CRCibernetica/cnft-tpl-esp32cam/README.md

# cnft-tpl-esp32cam
ESP32 camara shield with TPL5110 to control power consumption
