CRCibernetica/cnft-tpl-esp32cam/tpl-esp32/3dparts/TC-33X-1_ASMTC33.step

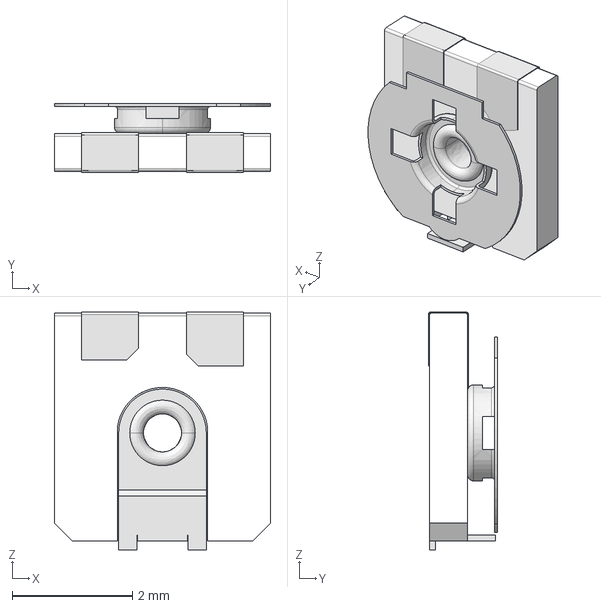
[picture p3: CAD file, 2024-03-14]
tpl-esp32/3dparts/TC-33X-1_ASMTC33.step
3.60 x 1.15 x 3.96 mm
