CRCibernetica/cnft-tpl-esp32cam/tpl-esp32/3dparts/B2B-PH-SM4-TB.step

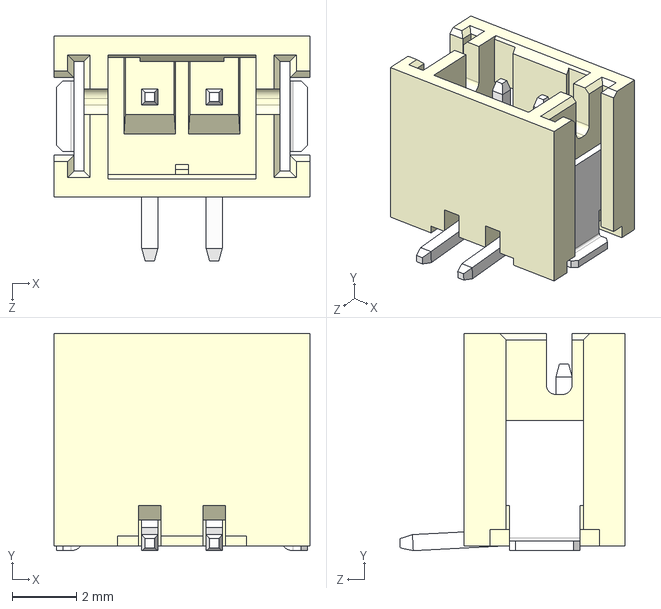
[picture p4: CAD file, 2024-03-14]
tpl-esp32/3dparts/B2B-PH-SM4-TB.step
7.95 x 6.75 x 7.00 mm
