CRCibernetica/cnft-tpl-esp32cam/tpl-esp32/3dparts/jst-sh-smd-connectors-1.snapshot.4/SMxxB-SRSS-TB/SM11B-SRSS-TB.STEP

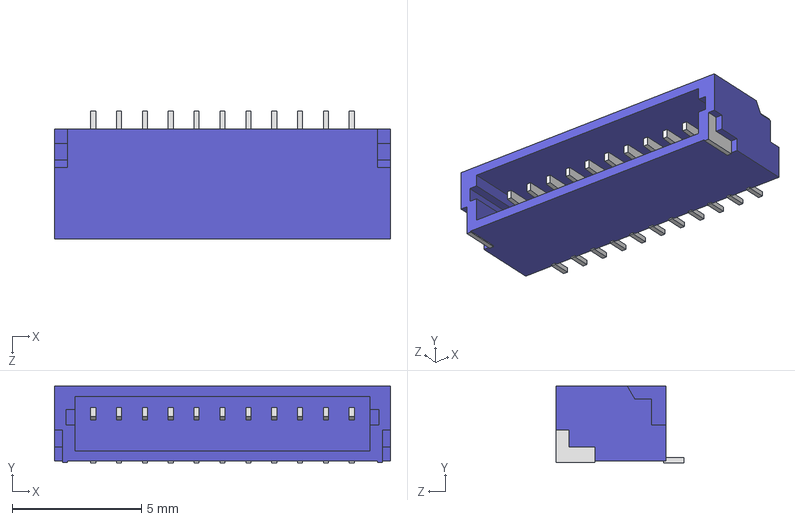
[picture p8: CAD file, 2024-03-14]
tpl-esp32/3dparts/jst-sh-smd-connectors-1.snapshot.4/SMxxB-SRSS-TB/SM11B-SRSS-TB.STEP
13.0 x 2.96 x 4.95 mm
