CRCibernetica/cnft-tpl-esp32cam/tpl-esp32/3dparts/jst-sh-smd-connectors-1.snapshot.4/SSH-003T-P0.2-H/SSH-003T-P0.2-H.STEP

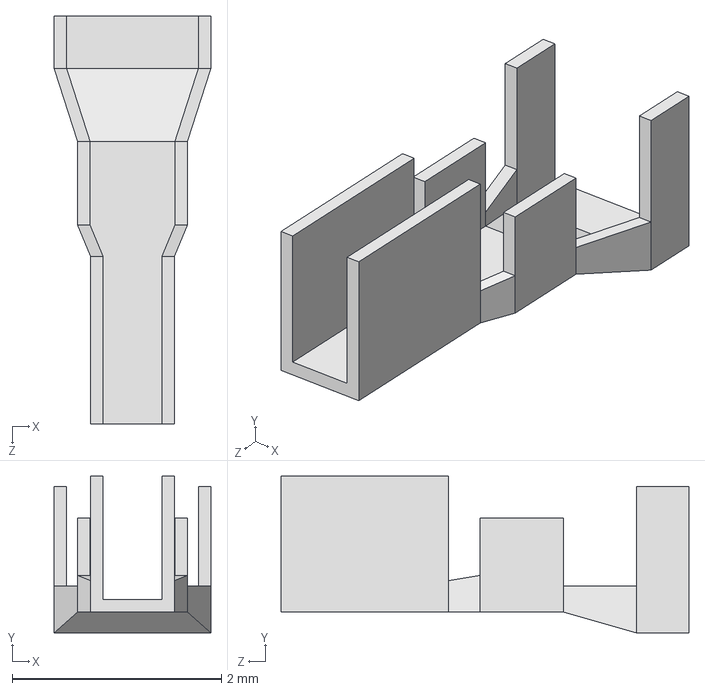
[picture p9: CAD file, 2024-03-14]
tpl-esp32/3dparts/jst-sh-smd-connectors-1.snapshot.4/SSH-003T-P0.2-H/SSH-003T-P0.2-H.STEP
1.50 x 1.50 x 3.90 mm
