CRCibernetica/cnft-tpl-esp32cam/tpl-esp32/3dparts/SOT23.step

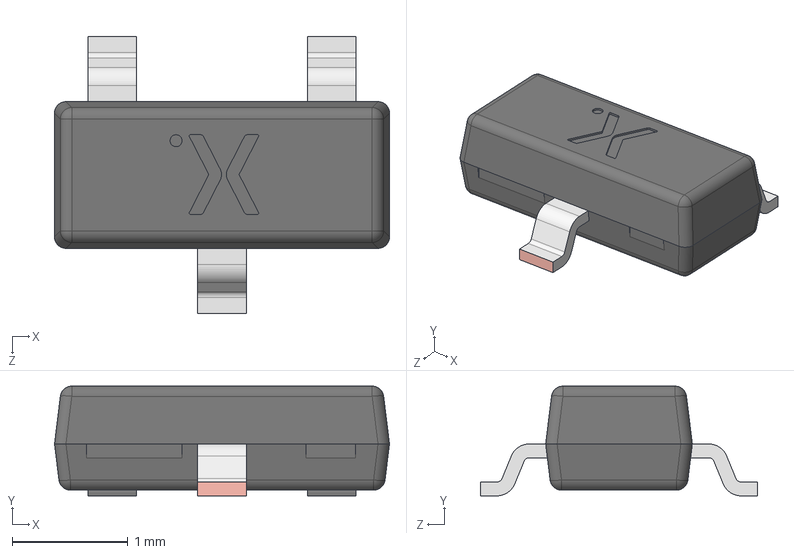
[picture p22: CAD file, 2024-03-14]
tpl-esp32/3dparts/SOT23.step
2.90 x 0.95 x 2.40 mm
SOT23 lower body
SOT23 Lead x 3
SOT23 Upper body
