CRCibernetica/cnft-tpl-esp32cam/(list of files, cad)

Other CAD files:
tpl-esp32/3dparts/TC-33X-2.stp
