CRCibernetica/cnft-tpl-esp32cam/(commit log)

2024-03-05 schematic design
    First approach to the ESP32-CAM shield
    [cnft-tpl-esp32cam.kicad_pcb, cnft-tpl-esp32cam.kicad_sch]
2024-03-14 Fab files ready v0.1
    [B2B-PH-SM4-TB.step, BM02B-SRSS-TB.STEP, BM03B-SRSS-TB.STEP, BM04B-SRSS-TB.STEP, BM05B-SRSS-TB.STEP, BM06B-SRSS-TB.STEP, BM07B-SRSS-TB.STEP, BM08B-SRSS-TB.STEP]
2024-03-22 Corrección conector de batería
    [cnft-tpl-esp32cam-CuBottom.gbr, cnft-tpl-esp32cam-CuTop.gbr, cnft-tpl-esp32cam-EdgeCuts.gbr, cnft-tpl-esp32cam-MaskBottom.gbr, cnft-tpl-esp32cam-MaskTop.gbr, cnft-tpl-esp32cam-NPTH.drl, cnft-tpl-esp32cam-PTH.drl, cnft-tpl-esp32cam-PasteBottom.gbr]
2024-03-26 Added text
    [BOM-cnft-tpl-esp32cam.csv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]
2025-10-03 Replaced SW1 pushbutton with solder points
    Pushbutton needs to be a remote button.
    [cnft-tpl-esp32cam.kicad_pcb]
2025-10-03 updated pot
    pot was no longer available. new sku selected and footprint added.
    [BOM-cnft-tpl-esp32cam.csv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]
